ashnliamo/Probe-Station-Debug/large_split.csv

Pad | Signal | X (um) | Y (um) | Land # | Hdr # | Net Class | I/O
P1 | VSS | 0.000 | -0.000 | 1 | J1-1 | Power
P2 | VDD | 0.000 | -4050.000 | 2 | J1-2 | Power
P3 | VSS | 150.000 | -0.000 | 3 | J1-3 | Power
P4 | VDD | 150.000 | -4050.000 | 4 | J1-4 | Power
P5 | VSS | 300.000 | -0.000 | 5 | J1-5 | Power
P6 | VDD | 300.000 | -4050.000 | 6 | J1-6 | Power
P7 | IN_1_7 | 450.000 | -0.000 | 7 | J1-7 | Signal | INPUT1
P8 | VDD | 450.000 | -4050.000 | 8 | J1-8 | Power
P9 | VSS | 600.000 | -0.000 | 9 | J1-9 | Power
P10 | VDD | 600.000 | -4050.000 | 10 | J1-10 | Power
P11 | VSS | 750.000 | -0.000 | 11 | J1-11 | Power
P12 | VDD | 750.000 | -4050.000 | 12 | J1-12 | Power
P13 | VSS | 900.000 | -0.000 | 13 | J1-13 | Power
P14 | VDD | 900.000 | -4050.000 | 14 | J1-14 | Power
P15 | IN_1_15 | 1050.000 | -0.000 | 15 | J1-15 | Signal | INPUT1
P16 | VDD | 1050.000 | -4050.000 | 16 | J1-16 | Power
P17 | VSS | 1200.000 | -0.000 | 17 | J1-17 | Power
P18 | VDD | 1200.000 | -4050.000 | 18 | J1-18 | Power
P19 | VSS | 1350.000 | -0.000 | 19 | J1-19 | Power
P20 | VDD | 1350.000 | -4050.000 | 20 | J1-20 | Power
P21 | VSS | 1500.000 | -0.000 | 21 | J1-21 | Power
P22 | VDD | 1500.000 | -4050.000 | 22 | J1-22 | Power
P23 | IN_1_23 | 1650.000 | -0.000 | 23 | J1-23 | Signal | INPUT1
P24 | VDD | 1650.000 | -4050.000 | 24 | J1-24 | Power
P25 | VSS | 1800.000 | -0.000 | 25 | J1-25 | Power
P26 | VDD | 1800.000 | -4050.000 | 26 | J1-26 | Power
P27 | VSS | 1950.000 | -0.000 | 27 | J1-27 | Power
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
P103 | VSS | 0.000 | -1500.000 | 103 | J1-103 | Power
P104 | IN_2_104 | 6150.000 | -1500.000 | 104 | J1-104 | Signal | INPUT2
P105 | VSS | 0.000 | -1650.000 | 105 | J1-105 | Power
P106 | VDD | 6150.000 | -1650.000 | 106 | J1-106 | Power
P107 | VSS | 0.000 | -1800.000 | 107 | J1-107 | Power
P108 | VDD | 6150.000 | -1800.000 | 108 | J1-108 | Power
P109 | OUT_1 | 0.000 | -1950.000 | 109 | J1-109 | Analog | OUTPUT1
P110 | VDD | 6150.000 | -1950.000 | 110 | J1-110 | Power
P111 | VSS | 0.000 | -2100.000 | 111 | J1-111 | Power
P112 | IN_2_112 | 6150.000 | -2100.000 | 112 | J1-112 | Signal | INPUT2
P113 | VSS | 0.000 | -2250.000 | 113 | J1-113 | Power
P114 | VDD | 6150.000 | -2250.000 | 114 | J1-114 | Power
P115 | VSS | 0.000 | -2400.000 | 115 | J1-115 | Power
P116 | VDD | 6150.000 | -2400.000 | 116 | J1-116 | Power
P117 | VSS | 0.000 | -2550.000 | 117 | J1-117 | Power
P118 | VDD | 6150.000 | -2550.000 | 118 | J1-118 | Power
P119 | VSS | 0.000 | -2700.000 | 119 | J1-119 | Power
P120 | IN_2_120 | 6150.000 | -2700.000 | 120 | J1-120 | Signal | INPUT2
P121 | VSS | 0.000 | -2850.000 | 121 | J1-121 | Power
P122 | VDD | 6150.000 | -2850.000 | 122 | J1-122 | Power
P123 | VSS | 0.000 | -3000.000 | 123 | J1-123 | Power
P124 | VDD | 6150.000 | -3000.000 | 124 | J1-124 | Power
P125 | VSS | 0.000 | -3150.000 | 125 | J1-125 | Power
P126 | VDD | 6150.000 | -3150.000 | 126 | J1-126 | Power
P127 | VSS | 0.000 | -3300.000 | 127 | J1-127 | Power
P128 | IN_2_128 | 6150.000 | -3300.000 | 128 | J1-128 | Signal | INPUT2
P129 | VSS | 0.000 | -3450.000 | 129 | J1-129 | Power
P130 | VDD | 6150.000 | -3450.000 | 130 | J1-130 | Power
P131 | VSS | 0.000 | -3600.000 | 131 | J1-131 | Power
P132 | VDD | 6150.000 | -3600.000 | 132 | J1-132 | Power
P133 | VSS | 0.000 | -3750.000 | 133 | J1-133 | Power
P134 | VDD | 6150.000 | -3750.000 | 134 | J1-134 | Power
P135 | VSS | 0.000 | -3900.000 | 135 | J1-135 | Power
P136 | IN_2_136 | 6150.000 | -3900.000 | 136 | J1-136 | Signal | INPUT2
