ashnliamo/Probe-Station-Debug/Testing Mask Generator/io_pair_outputs/calibration/calibration_resistors.csv

target_R_ohm | actual_R_ohm | measure_from | measure_to | trace_len_um
4000 | 3726.64 | B32;L12;L13;L19;L21;R14;R17;R26;T67;T70 | B23 | 37003
8000 | 7855.06 | B32;L12;L13;L19;L21;R14;R17;R26;T67;T70 | T50 | 74006
16000 | 15946.95 | B32;L12;L13;L19;L21;R14;R17;R26;T67;T70 | R20 | 148011
32000 | 31942.10 | B32;L12;L13;L19;L21;R14;R17;R26;T67;T70 | R11 | 296022
