ashnliamo/Probe-Station-Debug/Testing Mask Generator/io_pair_outputs/Shorted_signals_parallel.csv

chip | layer | half | input_pad | input_signal | output_pads | actual_R_ohm | total_len_um | group_parallel_R_ohm
1 | 1 | 1 | B16 | VDD18PLL<4> | B23;B32;R26 | 3956.09 | 37003 | 2114.435
1 | 1 | 1 | B13 | VDD18PLL<5> | B23;B32;R26 | 31681.26 | 296022 | 2114.435
1 | 1 | 1 | B39 | VDD18PLL<2> | B23;B32;R26 | 7975.49 | 74006 | 2114.435
1 | 1 | 1 | B42 | VDD18PLL<3> | B23;B32;R26 | 15818.82 | 148011 | 2114.435
1 | 1 | 2 | T13 | VDD18PLL<7> | L12;L13;L19;L21;R11;R14;R17;R20;T50;T67;T70 | 31681.26 | 296022 | 2114.435
1 | 1 | 2 | T16 | VDD18PLL<6> | L12;L13;L19;L21;R11;R14;R17;R20;T50;T67;T70 | 3956.09 | 37003 | 2114.435
1 | 1 | 2 | T39 | VDD18PLL<0> | L12;L13;L19;L21;R11;R14;R17;R20;T50;T67;T70 | 7975.49 | 74006 | 2114.435
1 | 1 | 2 | T42 | VDD18PLL<1> | L12;L13;L19;L21;R11;R14;R17;R20;T50;T67;T70 | 15818.82 | 148011 | 2114.435
2 | 1 | 1 | B17 | VDD08DLL<4> | B23;B32;R26 | 3962.93 | 37003 | 2115.816
2 | 1 | 1 | B12 | VDD08DLL<5> | B23;B32;R26 | 31676.12 | 296022 | 2115.816
2 | 1 | 1 | B38 | VDD08DLL<2> | B23;B32;R26 | 7966.36 | 74006 | 2115.816
2 | 1 | 1 | B43 | VDD08DLL<3> | B23;B32;R26 | 15823.95 | 148011 | 2115.816
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
