ashnliamo/Probe-Station-Debug/(commit log)

2026-07-06 should be ready to zip
    [calibration_resistors.csv, pinout_grouped_parallel.csv, testing.csv]
2026-07-07 added wafer displace of tiled chips
    [calibration_resistors.csv, pinout_grouped - Copy.csv, pinout_grouped - Copy_parallel.csv, pinout_grouped.csv, pinout_grouped_parallel.csv]
2026-07-07 update for alex
    [calibration_resistors.csv, pinout_grouped - Copy.csv, pinout_grouped - Copy_parallel.csv, pinout_grouped.csv, pinout_grouped_parallel.csv, test_corner_flips.csv, test_corner_flips_parallel.csv, test_dense_allsides.csv]
2026-07-09 auto probe card start
    [calibration_resistors.csv, pinout_grouped.csv, pinout_grouped_parallel.csv, test_corner_flips_parallel.csv]
2026-07-11 kicad script done?
    [pinout_grouped - Copy_probe_card.kicad_pcb, pinout_grouped - Copy_probe_pcb.kicad_pcb, pinout_grouped - Copy_wiring_map.csv, pinout_grouped_probe_pcb.kicad_pcb, temp2.kicad_pcb, temp2.kicad_sch, temp3.kicad_pcb, temp3.kicad_sch]
2026-07-13 altium script
    [pinout_grouped - Copy_probe_card.kicad_pcb, pinout_grouped - Copy_probe_pcb.kicad_pcb, temp4.kicad_sch, temp5.kicad_pcb, temp6.kicad_pcb, temp6.kicad_sch, temp7.kicad_pcb, temp7.kicad_sch]
2026-07-13 altium addition
    [PCB1.PcbDoc, calibration_resistors.csv, pinout_grouped - Copy_probe_card.kicad_pcb, pinout_grouped - Copy_probe_pcb.kicad_pcb, pinout_grouped - Copy_wiring_map.csv, pinout_grouped.csv, pinout_grouped_parallel.csv, pinout_grouped_probe_card.kicad_pcb]
2026-07-13 altium addition 2
    [PCB1.PcbDoc, pinout_grouped_probe_card.kicad_pcb, test.kicad_pcb, test.kicad_sch]
2026-07-14 finished, running tests now
    [PCB1.PcbDoc]
2026-07-15 general functionality complete
    [PCB1.PcbDoc, pinout_grouped_wiring_map.csv, t2_4side_300_wiring_map.csv]
2026-07-29 auto probe card stuff
    [PCB1.PcbDoc, PcbLib1.PcbLib, Probe_Card_Test.PrjPcb, SPI_Test.xlsx, Schlib1.SchLib, Shorted_signals.xlsx, Shorted_signals_parallel.csv, pinout_grouped_wiring_map.csv]
2026-07-30 reorganized files, finalized mask design
    [IO_Info.csv, Shorted_signals_parallel.csv, calibration_resistors.csv, common_bus.csv, large_split.csv, mixed_load.csv, pinout_grouped - Copy.csv, pinout_grouped_wiring_map.csv]
2026-08-04 reorganized files
    [Schlib1.SchLib, Shorted_signals.xlsx, Shorted_signals_parallel.csv, calibration_resistors.csv, common_bus.csv, large_split.csv, mixed_load.csv, pinout_grouped - Copy.csv]
2026-08-06 auto probe pcb now works. delete altium cache and projects, then empty trash before using
    [Schlib1.SchLib, pinout_grouped_wiring_map.csv]
